SanPollo/PerryFi2/images/pcb_back.png

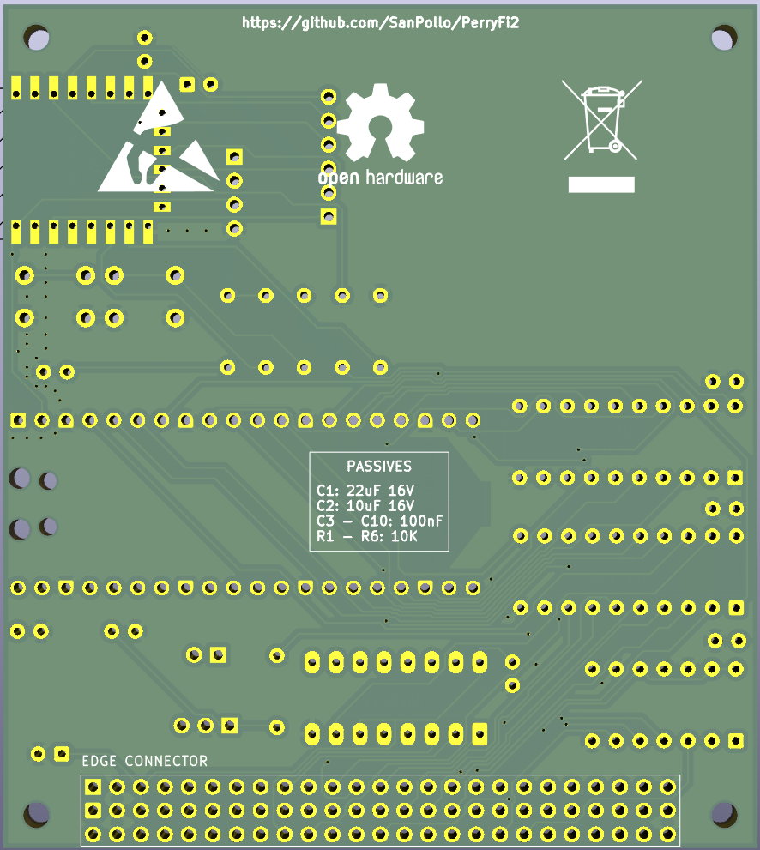
images/pcb_back.png
