SanPollo/PerryFi2/images/pcb_front.png

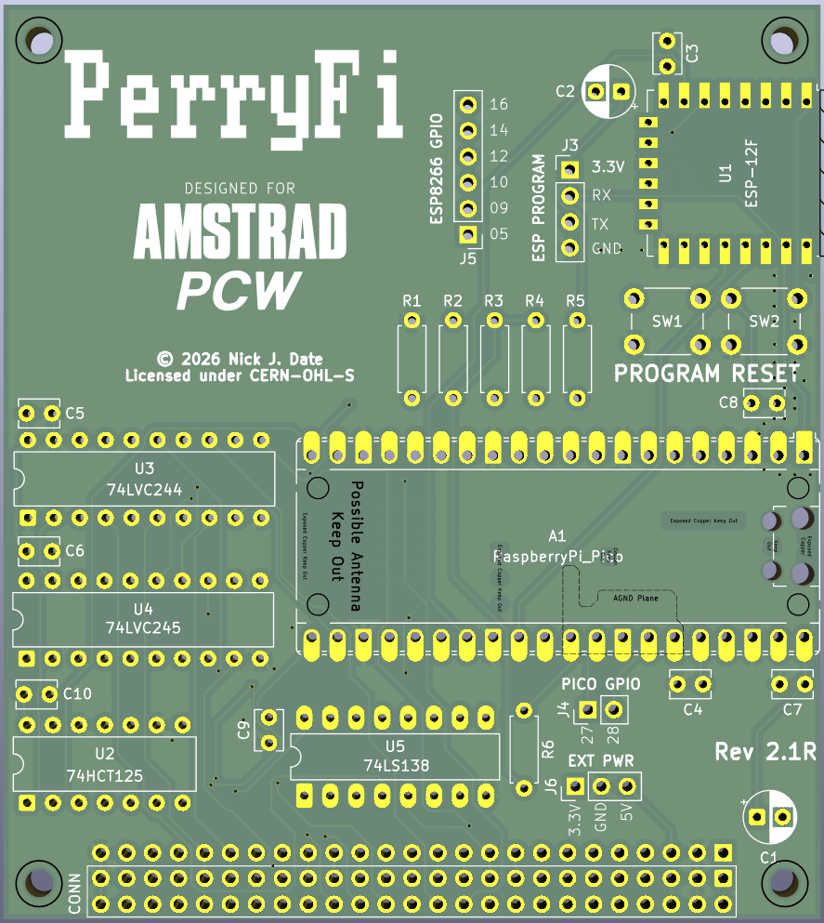
images/pcb_front.png
