SanPollo/PerryFi2/images/pf2backplane.jpg

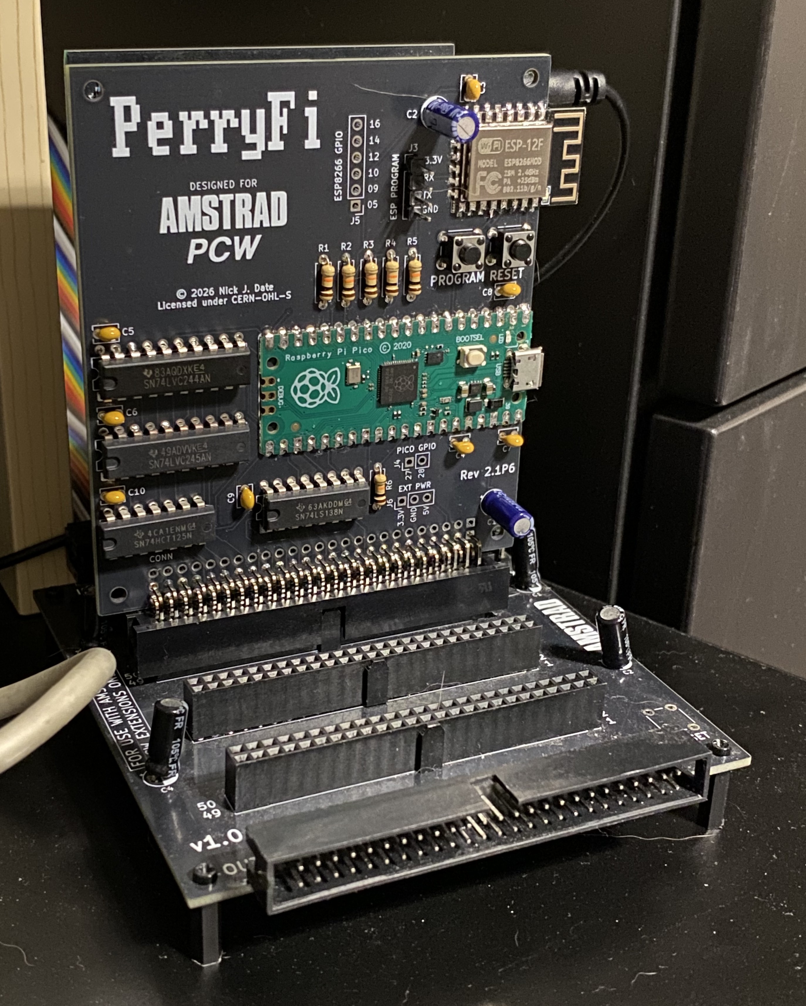
images/pf2backplane.jpg
