SanPollo/PerryFi2/schematics/PerryFi2.1.pdf

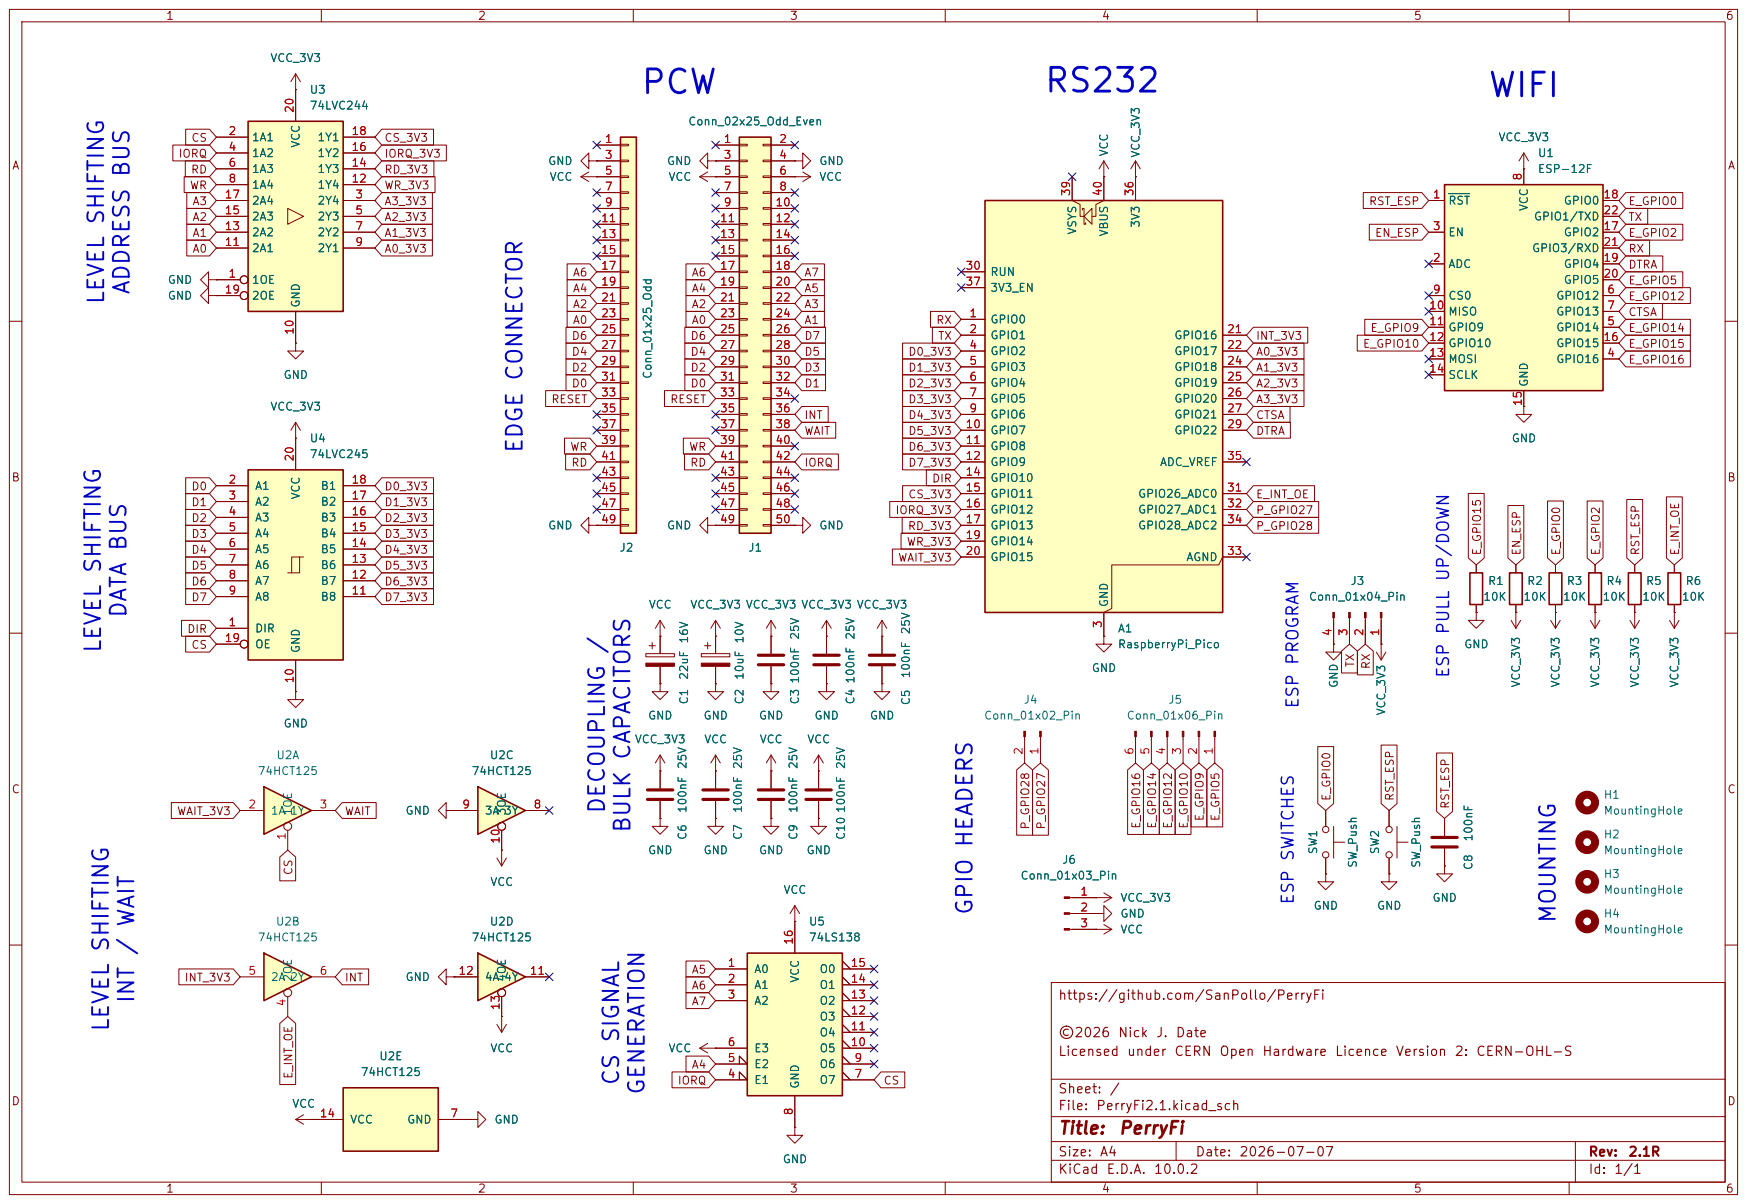
[picture p5: page 1]

https://github.com/SanPollo/PerryFi VCC

©2026 Nick J. Date
Licensed under CERN Open Hardware Licence Version 2: CERN-OHL-S

Size: A4 | Rev: 2.1R
KiCad E.D.A. 10.0.2 | Id: 1/1
