SanPollo/PerryFi2/schematics/PerryFi2.1.kicad_sch

## KiCad design schematics/PerryFi2.1.kicad_sch (2026-08-09)

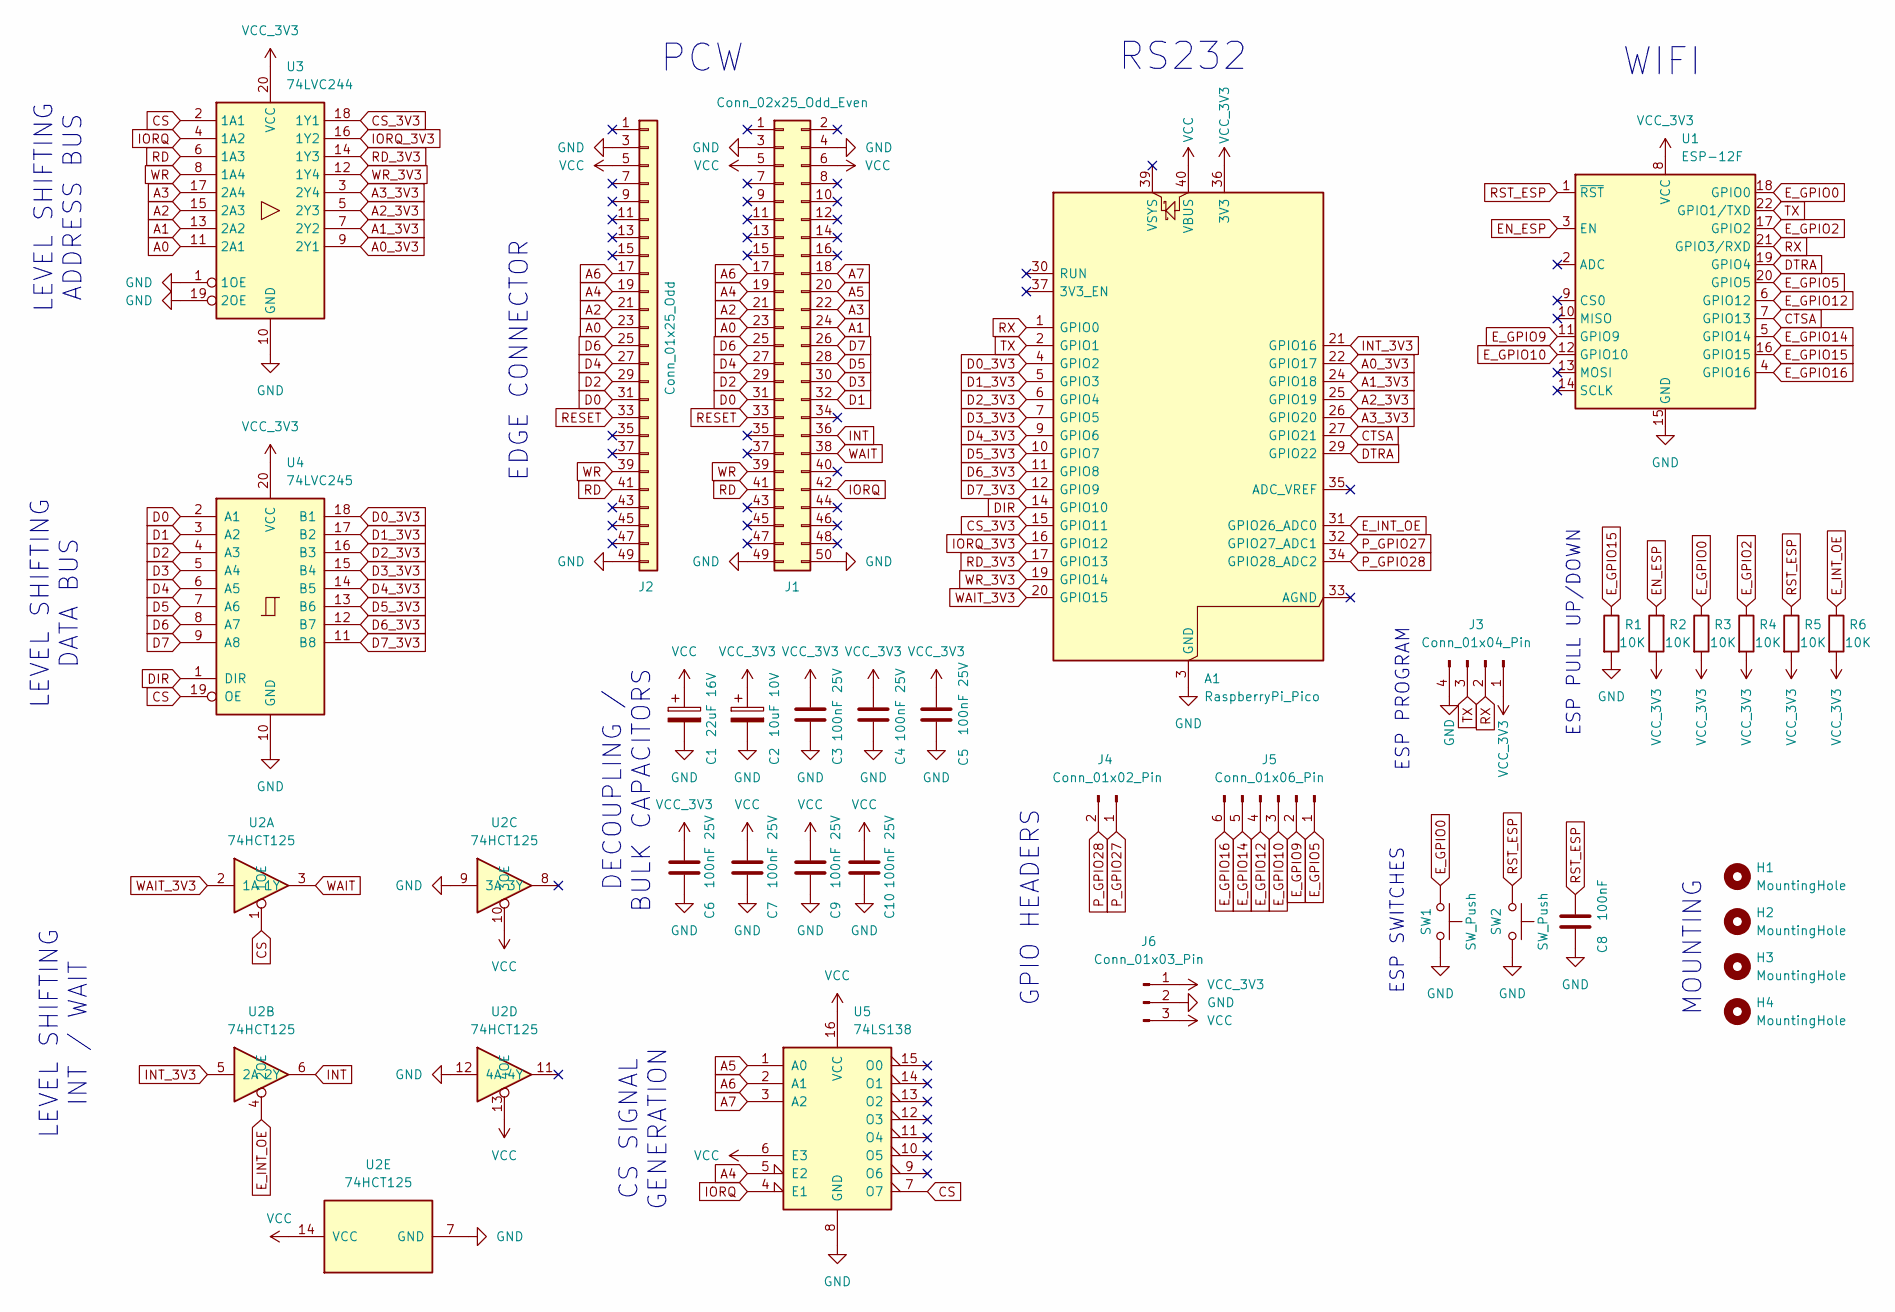
[picture p6: schematic PerryFi2.1.kicad_sch]

Parts:
A1: RaspberryPi_Pico; RaspberryPi_Pico_Common_Unspecified
C1: 22uF 16V; CP_Radial_D5.0mm_P2.50mm
C2: 10uF 10V; CP_Radial_D5.0mm_P2.50mm
C3, C4, C5, C6, C7, C9, C10: 100nF 25V; C_Disc_D3.8mm_W2.6mm_P2.50mm
C8: 100nF; C_Disc_D3.8mm_W2.6mm_P2.50mm
H1, H2, H3, H4: MountingHole; MountingHole_2.7mm_M2.5_ISO7380
J1: Conn_02x25_Odd_Even; IDC-Header_2x25_P2.54mm_Horizontal_No_Arrow
J2: Conn_01x25_Odd; PinHeader_1x25_P2.54mm_Vertical_Odd
J3: Conn_01x04_Pin; PinHeader_1x04_P2.54mm_Vertical
J4: Conn_01x02_Pin; PinHeader_1x02_P2.54mm_Vertical
J5: Conn_01x06_Pin; PinHeader_1x06_P2.54mm_Vertical
J6: Conn_01x03_Pin; PinHeader_1x03_P2.54mm_Vertical
R1, R2, R3, R4, R5, R6: 10K; R_Axial_DIN0207_L6.3mm_D2.5mm_P7.62mm_Horizontal
SW1, SW2: SW_Push; SW_PUSH_6mm_H4.3mm
U1: ESP-12F
U2: 74HCT125; DIP-14_W7.62mm
U3: 74LVC244; DIP-20_W7.62mm
U4: 74LVC245; DIP-20_W7.62mm
U5: 74LS138; DIP-16_W7.62mm_LongPads

Connections:
A0: J1.23, J2.23, U3.11 (2A1)
A0_3V3: A1.22 (GPIO17), U3.9 (2Y1)
A1: J1.24, U3.13 (2A2)
A1_3V3: A1.24 (GPIO18), U3.7 (2Y2)
A2: J1.21, J2.21, U3.15 (2A3)
A2_3V3: A1.25 (GPIO19), U3.5 (2Y3)
A3: J1.22, U3.17 (2A4)
A3_3V3: A1.26 (GPIO20), U3.3 (2Y4)
A4: J1.19, J2.19, U5.5 (E2)
A5: J1.20, U5.1 (A0)
A6: J1.17, J2.17, U5.2 (A1)
A7: J1.18, U5.3 (A2)
CS: U2.1 (1OE), U3.2 (1A1), U4.19 (OE), U5.7 (O7)
CS_3V3: A1.15 (GPIO11), U3.18 (1Y1)
CTSA: A1.27 (GPIO21), U1.7 (GPIO13)
D0: J1.31, J2.31, U4.2 (A1)
D0_3V3: A1.4 (GPIO2), U4.18 (B1)
D1: J1.32, U4.3 (A2)
D1_3V3: A1.5 (GPIO3), U4.17 (B2)
D2: J1.29, J2.29, U4.4 (A3)
D2_3V3: A1.6 (GPIO4), U4.16 (B3)
D3: J1.30, U4.5 (A4)
D3_3V3: A1.7 (GPIO5), U4.15 (B4)
D4: J1.27, J2.27, U4.6 (A5)
D4_3V3: A1.9 (GPIO6), U4.14 (B5)
D5: J1.28, U4.7 (A6)
D5_3V3: A1.10 (GPIO7), U4.13 (B6)
D6: J1.25, J2.25, U4.8 (A7)
D6_3V3: A1.11 (GPIO8), U4.12 (B7)
D7: J1.26, U4.9 (A8)
D7_3V3: A1.12 (GPIO9), U4.11 (B8)
DIR: A1.14 (GPIO10), U4.1 (DIR)
DTRA: A1.29 (GPIO22), U1.19 (GPIO4)
EN_ESP: R2.2, U1.3 (EN)
E_GPIO0: R3.1, SW1.1, U1.18 (GPIO0)
E_GPIO2: R4.1, U1.17 (GPIO2)
E_GPIO5: J5.1, U1.20 (GPIO5)
E_GPIO9: J5.2, U1.11 (GPIO9)
E_GPIO10: J5.3, U1.12 (GPIO10)
E_GPIO12: J5.4, U1.6 (GPIO12)
E_GPIO14: J5.5, U1.5 (GPIO14)
E_GPIO15: R1.1, U1.16 (GPIO15)
E_GPIO16: J5.6, U1.4 (GPIO16)
E_INT_OE: A1.31 (GPIO26_ADC0), R6.1, U2.4 (2OE)
GND: A1.3 (GND), A1.8 (GND), A1.13 (GND), A1.18 (GND), A1.23 (GND), A1.28 (GND), A1.38 (GND), C1.2, C2.2, C3.2, C4.2, C5.2, C6.2, C7.2, C8.2, C9.2, C10.2, J1.3, J1.4, J1.49, J1.50, J2.3, J2.49, J3.4, J6.2, R1.2, SW1.2, SW2.2, U1.15 (GND), U2.7 (GND), U2.9 (3A), U2.12 (4A), U3.1 (1OE), U3.10 (GND), U3.19 (2OE), U4.10 (GND), U5.8 (GND)
INT: J1.36, U2.6 (2Y)
INT_3V3: A1.21 (GPIO16), U2.5 (2A)
IORQ: J1.42, U3.4 (1A2), U5.4 (E1)
IORQ_3V3: A1.16 (GPIO12), U3.16 (1Y2)
P_GPIO27: A1.32 (GPIO27_ADC1), J4.1
P_GPIO28: A1.34 (GPIO28_ADC2), J4.2
RD: J1.41, J2.41, U3.6 (1A3)
RD_3V3: A1.17 (GPIO13), U3.14 (1Y3)
RESET: J1.33, J2.33
RST_ESP: C8.1, R5.1, SW2.1, U1.1 (~RST)
RX: A1.1 (GPIO0), J3.2, U1.21 (GPIO3/RXD)
TX: A1.2 (GPIO1), J3.3, U1.22 (GPIO1/TXD)
VCC: A1.40 (VBUS), C1.1, C7.1, C9.1, C10.1, J1.5, J1.6, J2.5, J6.3, U2.10 (3OE), U2.13 (4OE), U2.14 (VCC), U5.6 (E3), U5.16 (VCC)
VCC_3V3: A1.36 (3V3), C2.1, C3.1, C4.1, C5.1, C6.1, J3.1, J6.1, R2.1, R3.2, R4.2, R5.2, R6.2, U1.8 (VCC), U3.20 (VCC), U4.20 (VCC)
WAIT: J1.38, U2.3 (1Y)
WAIT_3V3: A1.20 (GPIO15), U2.2 (1A)
WR: J1.39, J2.39, U3.8 (1A4)
WR_3V3: A1.19 (GPIO14), U3.12 (1Y4)

Notes on the sheet:
MOUNTING
ESP PROGRAM
ESP PULL UP/DOWN
EDGE CONNECTOR
WIFI
LEVEL SHIFTING INT / WAIT
DECOUPLING / BULK CAPACITORS
ESP SWITCHES
CS SIGNAL GENERATION
LEVEL SHIFTING DATA BUS
RS232
PCW
GPIO HEADERS
LEVEL SHIFTING ADDRESS BUS
