SanPollo/PerryFi2/(commit log)

2026-08-09 BOM fixes, images uploaded
2026-08-09 Update README.md
    Added links to PCBWay project.
2026-08-09 Update BOM
2026-08-09 Upload schematics
    [PerryFi2.1.kicad_sch]
2026-08-09 Slight silkscreen change
